MartingLenoirDiego/tfe/images/ldoB.PNG

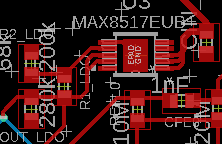
images/ldoB.PNG
