MartingLenoirDiego/tfe/documents/BoM tfe.xlsx

TFE : Epilepsy
 | Marting Lenoir Diego | 2022-03-30
# | Part Reference | Value | Package | Needed quantity per PCB | Quantity to order | Unit cost [€] | Total cost [€] | Description | Manufacturer Part Number | Manufacturer | Provider | Provider Part Number | Availability | Min quantity to order | Received
 | CVDD0 | 10µF | C0603 | 1 | 5 | 0.3900 | 1.9500 | CAPACITOR, 10µF, 0603, SMD | C0603C106M8PACTU | KEMET | Mouser | 80-C0603C106M8PACTU
 | CVVD1 | 10nF | C0603 | 1 | 5 | 0.1950 | 0.9750 | CAPACITOR, 10nF, 0603, SMD | 06033C103KAT2A | AVX | Mouser | 581-06033C103KAT2A
1 | CIN_LDO, COUT_LDO, C9VREF | 1µF | C0603 | 6 | 20 | 0.1690 | 3.3800 | CAPACITOR, 1µF, 0603, SMD | C1608X5R1H105K080AB | TDX | Mouser | 810-C1608X5R1H105K |  | 10
2 |  | 220nF | C0603 | 1 | 5 | 0.3050 | 1.5250 | CAPACITOR, 220nF, 0603, SMD | C0603C224K3RACTU | KEMET | Mouser | 80-C0603C224K3R
3 | CFILT1, CFILT2, CFILT3 | 150nF | C0603 | 3 | 10 | 0.0580 | 0.5800 | CAPACITOR, 150nF, 0603, SMD | C0603C154K5RACTU | KEMET | Mouser | 80-C0603C154K5R |  | 10
4 | CFILT2 | 100nF | C0603 | 1 | 5 | 0.3500 | 1.7500 | CAPACITOR, 100nF, 0603, SMD | 06033C104KAT2A | AVX | Mouser | 581-06033C104KAT2A |  | 10
5 | CFE0/1/2/3 | 1nF | C0603 | 4 | 10 | 0.0440 | 0.4400 | CAPACITOR, 1nF, 0603, SMD | 06031C102JAT2A | AVX | Mouser | 581-06031C102J |  | 10
6 | C_AAF_0/1/2/3 | 0,1nF | C0603 | 4 | 10 | 0.1050 | 1.0500 | CAPACITOR, 0,1nF, 0603, SMD | C0603C101K5RACTU | KEMET | Mouser | 80-C0603C101K5R |  | 10
7 | RFILT0, RFILT1, RFILT2 | 100MΩ | R0603 | 7 | 20 | 0.2520 | 5.0400 | RESISTOR, 100Mohm, 0603, SMD | CRCW0603100MJPEAHR | VISHAY | Mouser | 71-CRCW0603100MJPEA |  | 10
8 | RFER0/1/2/3, R9VREF | 20MΩ | R0603 | 5 | 10 | 0.3470 | 3.4700 | RESISTOR, 20Mohm, 0603, SMD | CRCW060320M0JPEAHR | VISHAY | Mouser | 71-CRCW0603J-20M-E3 |  | 10
9 | R0,6V, R0,9V, RFEL0/1/2/3 | 10MΩ | R0603 | 6 | 15 | 0.0220 | 0.3300 | RESISTOR, 10Mohm, 0603, SMD | CRCW060310M0FKEAC | VISHAY | Mouser | 71-CRCW060310M0FKEAC |  | 10
10 | R40, R41, R42, R43 | 7,5MΩ | R0603 | 4 | 10 | 0.0270 | 0.2700 | RESISTOR, 7,5Mohm, 0603, SMD | CRCW06037M50JNEA | VISHAY | Mouser | 71-CRCW0603J-7.5M-E3 |  | 1
11 | R30, R31, R32, R33 | 3MΩ | R0603 | 4 | 10 | 0.0260 | 0.2600 | RESISTOR, 3Mohm, 0603, SMD | CRCW06033M00FKEA | VISHAY | Mouser | 71-CRCW0603-3M-E3 |  | 10
12 | RLM334 | 68kΩ | R0603 | 2 | 10 | 0.0300 | 0.3000 | RESISTOR, 68kohm, 0603, SMD | CRCW060368K0FKEA | VISHAY | Mouser | 71-CRCW0603-68K-E3 |  | 10
13 | R_AAF_0/1/2/3 | 40kΩ | R0603 | 4 | 10 | 0.0260 | 0.2600 | RESISTOR, 40,2kohm, 0603, SMD | CRCW060340K2FKEA | VISHAY | Mouser | 71-CRCW0603-40.2K-E3 |  | 10
 |  | 28kΩ | R0603 | 1 | 10 | 0.0260 | 0.2600 | RESISTOR, 28kohm, 0603, SMD | CRCW060328K0FKEA | VISHAY | Mouser | 71-CRCW0603-28K-E3 |  | 10
 |  | 20kΩ | R0603 | 1 | 10 | 0.0250 | 0.2500 | RESISTOR, 20kohm, 0603, SMD | CRCW060320K0FKEB | VISHAY | Mouser | 71-CRCW060320K0FKEB |  | 10
14 | R20, R21, R22, R23 | 15kΩ | R0603 | 4 | 10 | 0.0240 | 0.2400 | RESISTOR, 15kohm, 0603, SMD | CRCW060315K0JNEA | VISHAY | Mouser | 71-CRCW0603J-15K-E3 |  | 10
15 |  | 2,8kΩ | R0603 | 1 | 5 | 0.1440 | 0.7200 | RESISTOR, 2,8kohm, 0603, SMD | CRCW06032K80FKEAHP | VISHAY | Mouser | 71-CRCW06032K80FKEAH |  | 10
16 |  | 2kΩ | R0603 | 1 | 5 | 0.0850 | 0.4250 | RESISTOR, 2kohm, 0603, SMD | CRCW06032K00FKEAC | VISHAY | Mouser | 71-CRCW06032K00FKEAC |  | 10
17 | R10, R11 | 1kΩ | R0603 | 4 | 10 | 0.0220 | 0.2200 | RESISTOR, 1kohm, 0603, SMD | CRCW06031K00FKEAC | VISHAY | Mouser | 71-CRCW06031K00FKEAC |  | 10
18 | LMD334DT | Current Sources | SO-8 | 2 | 5 | 0.9200 | 4.6000 | Régulateur de courant | LM334DT | STMICROELECTRONICS | Mouser | 511-LM334D-TR |  | 1
 | TPS7A0518PDBZR |  | DBZ | 1 | 3 | 0.6920 | 2.0760 | TPS7A0518PDBZR | TPS7A0518PDBZR | Texas Instruments | Mouser | 595-TPS7A0518PDBZR |  | 1
19 | TLV9042IDR | Ampli Op | SOIC-8 | 4 | 10 | 0.7280 | 7.2800 | Operational Amplifiers | TLV9042IDR | Texas Instruments | Mouser | 595-TLV9042IDR |  | 1
 |  | TOTAL = |  | 72 | 223 |  | 37.6510
