MartingLenoirDiego/tfe/schémas + board/PCB.brd

## EAGLE design schémas + board/PCB.brd (2022-03-17)

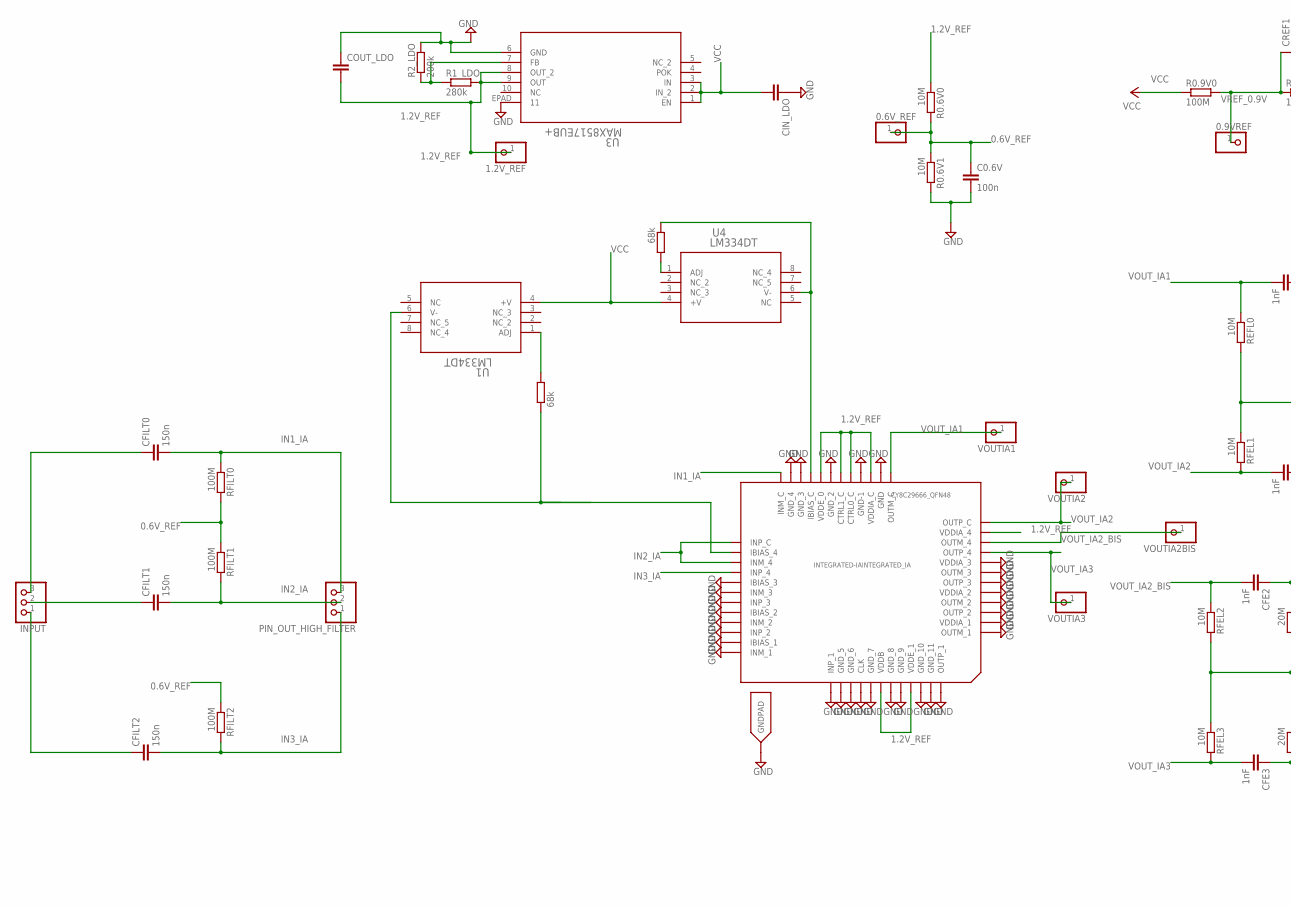
[picture p31: schematic PCB.sch, part in row 1, column 1]

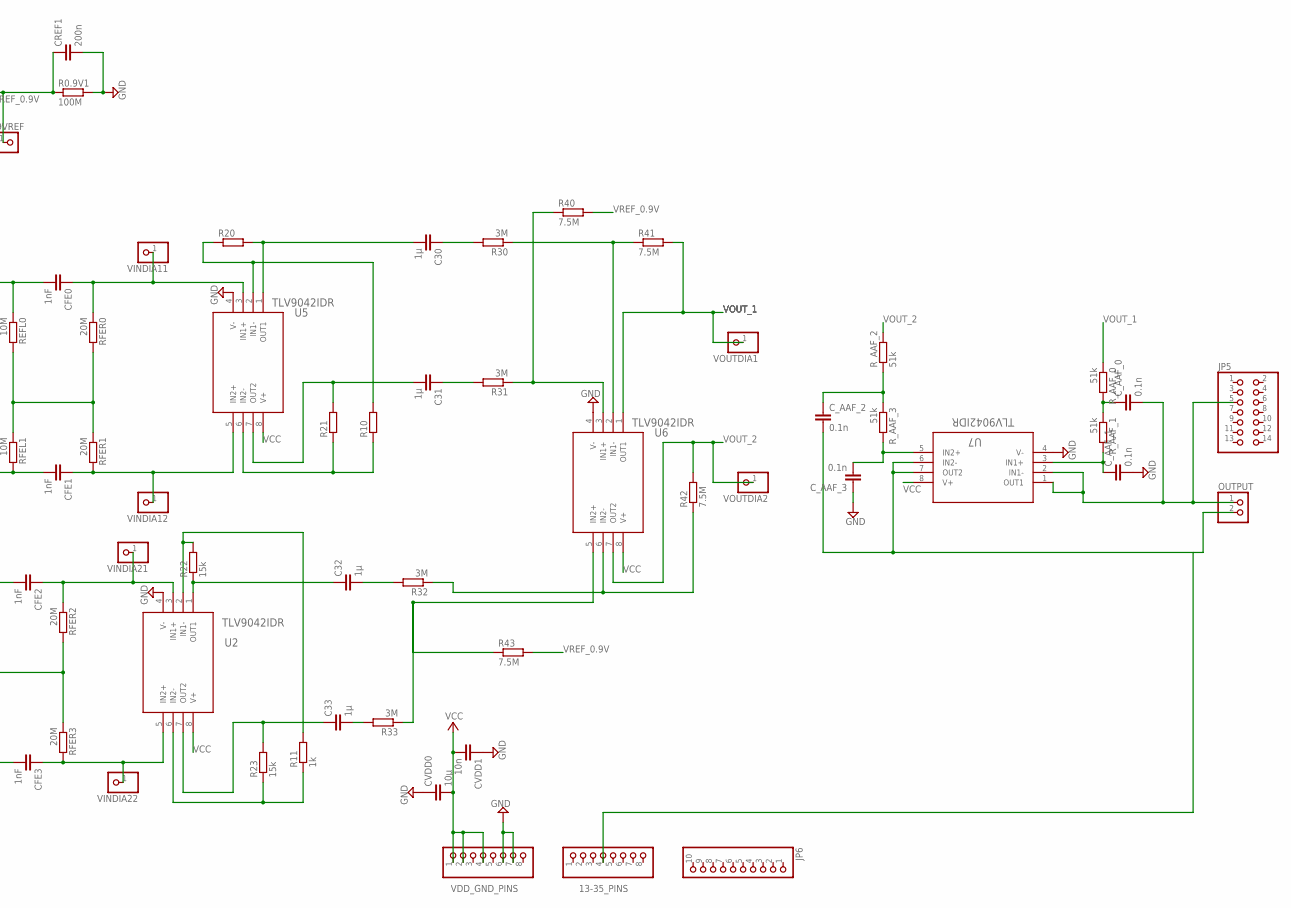
[picture p32: schematic PCB.sch, part in row 1, column 2]

Parts:
0.6V_REF, 0.9VREF, 1.2V_REF: PINHD-1X1; 1X01
13-35_PINS: PINHD-1X8; 1X08
C0.6V: 100n; C0603
C30, C31, C32, C33: 1µ; C0603
CFE0, CFE1, CFE2, CFE3: 1nF; C0603
CFILT0, CFILT1, CFILT2: 150n; C0603
CIN_LDO: 1µ; C0603
COUT_LDO: 4.7µ; C0603
CREF1: 200n; C0603
CVDD0: 10µ; C0603
CVDD1: 10n; C0603
C_AAF_0, C_AAF_1, C_AAF_2, C_AAF_3: 0.1n; C0603
INPUT: PINHD-1X3; 1X03
INTEGRATED-IA: CY8C29666_QFN48; QFN48
JP5: PINHD-2X7; 2X07
JP6: PINHD-1X10; 1X10
OUTPUT: PINHD-1X2; 1X02
PIN_OUT_HIGH_FILTER: PINHD-1X3; 1X03
R0.6V0, R0.6V1: 10M; R0603
R0.9V0, R0.9V1: 100M; R0603
R1_LDO: 280k; R0603
R2_LDO: 200k; R0603
R10, R20, R21: R-EU_R0603; R0603
R11: 1k; R0603
R22, R23: 15k; R0603
R30, R31, R32, R33: 3M; R0603
R40, R41, R42, R43: 7.5M; R0603
REFL0: 10M; R0603
RFEL1, RFEL2, RFEL3: 10M; R0603
RFER0, RFER1, RFER2, RFER3: 20M; R0603
RFILT0, RFILT1, RFILT2: 100M; R0603
RLM334_0, RLM334_1: 68k; R0603
R_AAF_0, R_AAF_1, R_AAF_2, R_AAF_3: 51k; R0603
U1, U4: LM334DT; SO-8_STM
U2, U5, U6, U7: TLV9042IDR; SOIC8_D_TEX
U3: MAX8517EUB+; 21-0109D_MXM
VDD_GND_PINS: PINHD-1X8; 1X08
VINDIA11, VINDIA12, VINDIA21, VINDIA22: PINHD-1X1; 1X01
VOUTDIA1, VOUTDIA2: PINHD-1X1; 1X01
VOUTIA1, VOUTIA2, VOUTIA2BIS, VOUTIA3: PINHD-1X1; 1X01

Connections:
0.6V_REF: 0.6V_REF.1, C0.6V.1, R0.6V0.2, R0.6V1.1, RFILT0.2, RFILT1.1, RFILT2.1
1.2V_REF: 1.2V_REF.1, COUT_LDO.2, INTEGRATED-IA.11 (VDDIA_4), INTEGRATED-IA.15 (VDDIA_C), INTEGRATED-IA.17 (CTRL0_C), INTEGRATED-IA.18 (CTRL1_C), INTEGRATED-IA.20 (VDDE_0), INTEGRATED-IA.42 (VDDB), INTEGRATED-IA.45 (VDDE_1), R0.6V0.1, R1_LDO.2, U3.8 (OUT_2), U3.9 (OUT)
GND: C0.6V.2, CIN_LDO.1, COUT_LDO.1, CREF1.2, CVDD0.1, CVDD1.1, C_AAF_1.2, C_AAF_3.1, INTEGRATED-IA.1 (OUTM_1), INTEGRATED-IA.2 (VDDIA_1), INTEGRATED-IA.3 (OUTP_2), INTEGRATED-IA.4 (OUTM_2), INTEGRATED-IA.5 (VDDIA_2), INTEGRATED-IA.6 (OUTP_3), INTEGRATED-IA.7 (OUTM_3), INTEGRATED-IA.8 (VDDIA_3), INTEGRATED-IA.14 (GND), INTEGRATED-IA.16 (GND-1), INTEGRATED-IA.19 (GND_2), INTEGRATED-IA.22 (GND_3), INTEGRATED-IA.23 (GND_4), INTEGRATED-IA.29 (IBIAS_3), INTEGRATED-IA.30 (INM_3), INTEGRATED-IA.31 (INP_3), INTEGRATED-IA.32 (IBIAS_2), INTEGRATED-IA.33 (INM_2), INTEGRATED-IA.34 (INP_2), INTEGRATED-IA.35 (IBIAS_1), INTEGRATED-IA.36 (INM_1), INTEGRATED-IA.37 (INP_1), INTEGRATED-IA.38 (GND_5), INTEGRATED-IA.39 (GND_6), INTEGRATED-IA.40 (CLK), INTEGRATED-IA.41 (GND_7), INTEGRATED-IA.43 (GND_8), INTEGRATED-IA.44 (GND_9), INTEGRATED-IA.46 (GND_10), INTEGRATED-IA.47 (GND_11), INTEGRATED-IA.48 (OUTP_1), INTEGRATED-IA.EXP (GNDPAD), R0.6V1.2, R0.9V1.2, R2_LDO.2, U2.4 (V-), U3.6 (GND), U3.EPAD (11), U5.4 (V-), U6.4 (V-), U7.4 (V-), VDD_GND_PINS.6, VDD_GND_PINS.7
IN1_IA: CFILT0.2, INTEGRATED-IA.24 (INM_C), PIN_OUT_HIGH_FILTER.3, RFILT0.1
IN2_IA: CFILT1.2, INTEGRATED-IA.25 (INP_C), INTEGRATED-IA.27 (INM_4), PIN_OUT_HIGH_FILTER.2, RFILT1.2
IN3_IA: CFILT2.2, INTEGRATED-IA.28 (INP_4), PIN_OUT_HIGH_FILTER.1, RFILT2.2
unnamed: C33.2, R33.2
unnamed: C32.1, R22.1, U2.1 (OUT1)
unnamed: C32.2, R32.2
unnamed: R32.1, R42.1, U6.6 (IN2-)
unnamed: CFILT2.1, INPUT.1
unnamed: R33.1, R43.1, U6.5 (IN2+)
unnamed: REFL0.2, RFEL1.1, RFER0.2, RFER1.1
unnamed: R31.1, R40.1, U6.3 (IN1+)
unnamed: C31.1, R31.2
unnamed: C30.1, R30.2
unnamed: C31.2, R21.2, U5.7 (OUT2)
unnamed: RLM334_1.2, U1.1 (ADJ)
unnamed: CFILT0.1, INPUT.3
unnamed: R1_LDO.1, R2_LDO.1, U3.7 (FB)
unnamed: RLM334_0.2, U4.1 (ADJ)
unnamed: C_AAF_2.1, R_AAF_2.1, R_AAF_3.1
unnamed: C30.2, R20.2, U5.1 (OUT1)
unnamed: C_AAF_0.1, R_AAF_0.2, R_AAF_1.1
unnamed: C_AAF_1.1, R_AAF_1.2, U7.3 (IN1+)
unnamed: C_AAF_3.2, R_AAF_3.2, U7.5 (IN2+)
unnamed: 13-35_PINS.4, C_AAF_2.2, OUTPUT.2, U7.6 (IN2-), U7.7 (OUT2)
unnamed: C_AAF_0.2, JP5.5, OUTPUT.1, U7.1 (OUT1), U7.2 (IN1-)
unnamed: R30.1, R41.1, U6.2 (IN1-)
unnamed: R10.1, R21.1, U5.6 (IN2-)
unnamed: C33.1, R23.2, U2.7 (OUT2)
unnamed: R11.1, R23.1, U2.6 (IN2-)
unnamed: R10.2, R20.1, U5.2 (IN1-)
unnamed: INTEGRATED-IA.26 (IBIAS_4), RLM334_1.1, U1.6 (V-)
unnamed: R11.2, R22.2, U2.2 (IN1-)
unnamed: CFE3.1, RFER3.2, U2.5 (IN2+), VINDIA22.1
unnamed: RFEL2.2, RFEL3.1, RFER2.2, RFER3.1
unnamed: CFE2.1, RFER2.1, U2.3 (IN1+), VINDIA21.1
unnamed: INTEGRATED-IA.21 (IBIAS_C), RLM334_0.1, U4.6 (V-)
unnamed: CFE0.1, RFER0.1, U5.3 (IN1+), VINDIA11.1
unnamed: CFE1.1, RFER1.2, U5.5 (IN2+), VINDIA12.1
unnamed: CFILT1.1, INPUT.2
VCC: CIN_LDO.2, CVDD0.2, CVDD1.2, R0.9V0.1, U1.4 (+V), U2.8 (V+), U3.1 (EN), U3.2 (IN_2), U3.3 (IN), U4.4 (+V), U5.8 (V+), U6.8 (V+), U7.8 (V+), VDD_GND_PINS.1, VDD_GND_PINS.2, VDD_GND_PINS.4
VOUT_1: R41.2, R_AAF_0.1, U6.1 (OUT1), VOUTDIA1.1
VOUT_2: R42.2, R_AAF_2.2, U6.7 (OUT2), VOUTDIA2.1
VOUT_IA1: CFE0.2, INTEGRATED-IA.13 (OUTM_C), REFL0.1, VOUTIA1.1
VOUT_IA2: CFE1.2, INTEGRATED-IA.12 (OUTP_C), RFEL1.2, VOUTIA2.1
VOUT_IA2_BIS: CFE2.2, INTEGRATED-IA.10 (OUTM_4), RFEL2.1, VOUTIA2BIS.1
VOUT_IA3: CFE3.2, INTEGRATED-IA.9 (OUTP_4), RFEL3.2, VOUTIA3.1
VREF_0.9V: 0.9VREF.1, CREF1.1, R0.9V0.2, R0.9V1.1, R40.2, R43.2

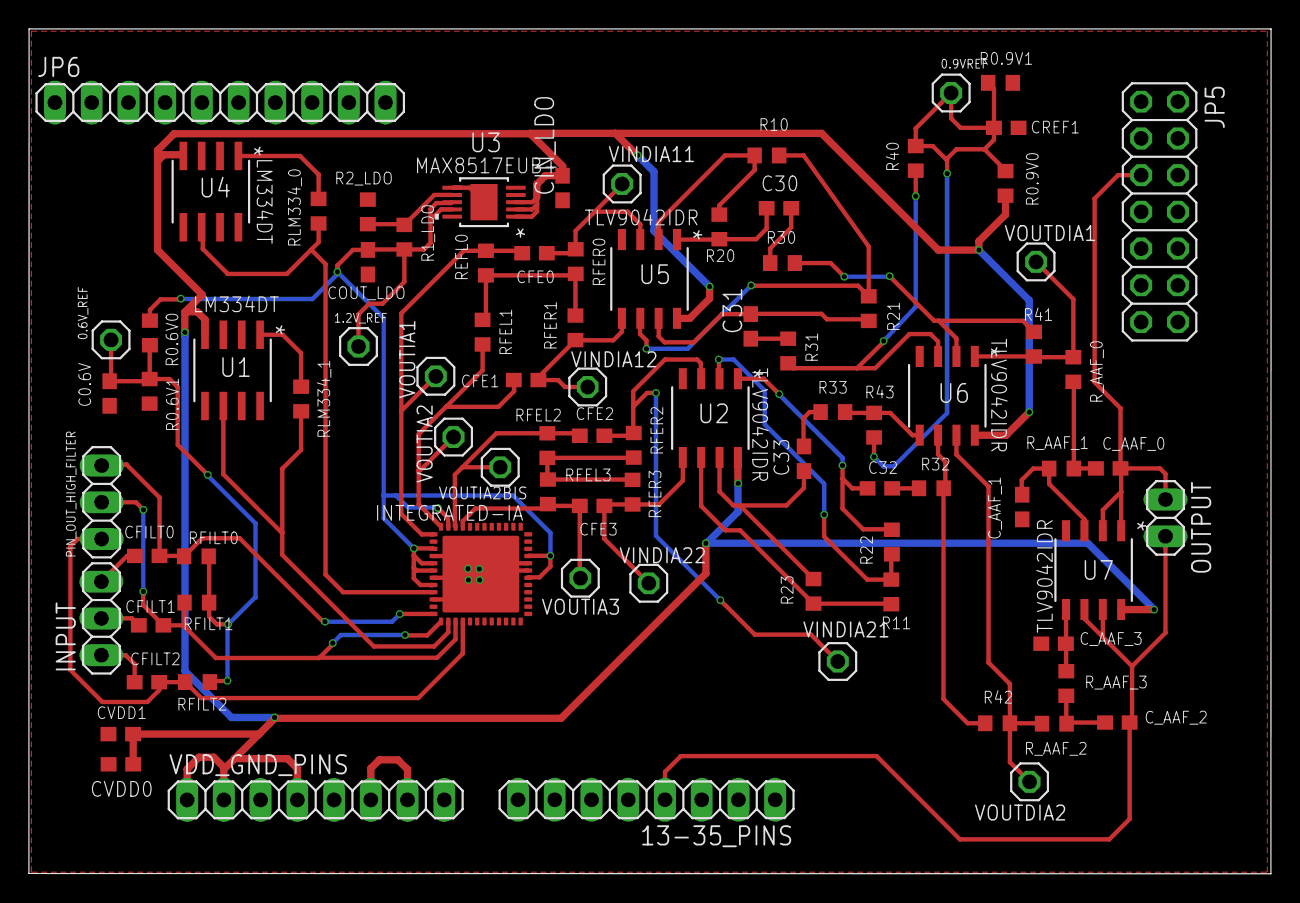
[picture p33: board PCB.brd from above]

Board: 2 copper layers, 85.9 x 58.4 mm, 86 parts (0 on the bottom side), 50 nets.
