MartingLenoirDiego/tfe/code/Apollo/common/base_types.h

/*******************************************************************************
* Copyright (C) 2013-2016, Fujitsu Electronics Europe GmbH or a                *
* subsidiary of Fujitsu Electronics Europe GmbH.  All rights reserved.         *
*                                                                              *
* This software, including source code, documentation and related              *
* materials ("Software"), is owned by Fujitsu Electronics Europe GmbH or       *
* one of its subsidiaries ("Fujitsu").
*                                                                              *
* If no EULA applies, Fujitsu hereby grants you a personal, non-exclusive,     *
* non-transferable license to copy, modify, and compile the                    *
* Software source code solely for use in connection with Fujitsu's             *
* integrated circuit products.  Any reproduction, modification, translation,   *
* compilation, or representation of this Software except as specified          *
* above is prohibited without the express written permission of Fujitsu.       *
*                                                                              *
* Disclaimer: THIS SOFTWARE IS PROVIDED AS-IS, WITH NO                         *
* WARRANTY OF ANY KIND, EXPRESS OR IMPLIED, INCLUDING,                         *
* BUT NOT LIMITED TO, NONINFRINGEMENT, IMPLIED                                 *
* WARRANTIES OF MERCHANTABILITY AND FITNESS FOR A                              *
* PARTICULAR PURPOSE. Fujitsu reserves the right to make                       *
* changes to the Software without notice. Fujitsu does not assume any          *
* liability arising out of the application or use of the Software or any       *
* product or circuit described in the Software. Fujitsu does not               *
* authorize its products for use in any products where a malfunction or        *
* failure of the Fujitsu product may reasonably be expected to result in       *
* significant property damage, injury or death ("High Risk Product"). By       *
* including Fujitsu's product in a High Risk Product, the manufacturer         *
* of such system or application assumes all risk of such use and in doing      *
* so agrees to indemnify Fujitsu against all liability.                        *
*******************************************************************************/

/*****************************************************************************/
/** \file base_types.h
 **
 ** Additional base type definitions to stddef.h and stdint.h
 **
 ** History:
 **   - 2016-09-12  1.0  Manuel Schreiner  First version.
 **
 *****************************************************************************/

#ifndef __BASE_TYPES_H__
#define __BASE_TYPES_H__

/*****************************************************************************/
/* Include files                                                             */
/*****************************************************************************/
#include <stddef.h>
#include "stdint.h"
  
/*****************************************************************************/
/* Global pre-processor symbols/macros ('#define')                           */
/*****************************************************************************/
#ifndef TRUE
  /** Value is true (boolean_t type) */
  #define TRUE        ((boolean_t) 1)
#endif

#ifndef FALSE
  /** Value is false (boolean_t type) */
  #define FALSE       ((boolean_t) 0)
#endif  

/** Returns the minimum value out of two values */
#define MIN( X, Y )  ((X) < (Y) ? (X) : (Y))

/** Returns the maximum value out of two values */
#define MAX( X, Y )  ((X) > (Y) ? (X) : (Y))

/** Returns the dimension of an array */
#define DIM( X )  (sizeof(X) / sizeof(X[0]))

/******************************************************************************
 * Global type definitions
 ******************************************************************************/

/** logical datatype (only values are TRUE and FALSE) */
typedef uint8_t      boolean_t;
  
/** single precision floating point number (4 byte) */
typedef float        float32_t;

/** double precision floating point number (8 byte) */
typedef double       float64_t;

/** ASCCI character for string generation (8 bit) */
typedef char         char_t;

/** function pointer type to void/void function */
typedef void         (*func_ptr_t)(void);

/** function pointer type to void/uint8_t function */
typedef void         (*func_ptr_arg1_t)(uint8_t);

/** generic error codes */
typedef enum en_result
{
    Ok                          = 0,  ///< No error
    Error                       = 1,  ///< Non-specific error code
    ErrorAddressAlignment       = 2,  ///< Address alignment does not match
    ErrorAccessRights           = 3,  ///< Wrong mode (e.g. user/system) mode is set
    ErrorInvalidParameter       = 4,  ///< Provided parameter is not valid
    ErrorOperationInProgress    = 5,  ///< A conflicting or requested operation is still in progress
    ErrorInvalidMode            = 6,  ///< Operation not allowed in current mode
    ErrorUninitialized          = 7,  ///< Module (or part of it) was not initialized properly
    ErrorBufferFull             = 8,  ///< Circular buffer can not be written because the buffer is full
    ErrorTimeout                = 9,  ///< Time Out error occurred (e.g. I2C arbitration lost, Flash time-out, etc.)
    ErrorNotReady               = 10, ///< A requested final state is not reached
    OperationInProgress         = 11  ///< Indicator for operation in progress (e.g. ADC conversion not finished, DMA channel used, etc.)
} en_result_t;     

/*****************************************************************************/
/* Global variable declarations ('extern', definition in C source)           */
/*****************************************************************************/

/*****************************************************************************/
/* Global function prototypes ('extern', definition in C source)             */
/*****************************************************************************/

#endif /* __BASE_TYPES_H__ */

/******************************************************************************/
/* EOF (not truncated)                                                        */
/******************************************************************************/
