MartingLenoirDiego/tfe/code/Apollo/common/system_apollo3.h

//*****************************************************************************
//
//! @file system_Apollo3.h
//!
//! @brief Ambiq Micro Apollo3 MCU specific functions.
//
//*****************************************************************************

//*****************************************************************************
//
// ${copyright}
//
//*****************************************************************************

#ifndef SYSTEM_APOLLO3_H
#define SYSTEM_APOLLO3_H

#ifdef __cplusplus
extern "C" {
#endif

#include <stdint.h>

extern uint32_t SystemCoreClock;     // System Clock Frequency (Core Clock)

//*****************************************************************************
//
// External function definitions
//
//*****************************************************************************
extern void SystemInit (void);
extern void SystemCoreClockUpdate (void);

#ifdef __cplusplus
}
#endif

#endif  // SYSTEM_APOLLO3_H
