MartingLenoirDiego/tfe/(commit log)

2022-03-30 mise à jour bom
    [BOM.xlsx, Copie de BOM.xlsx]
2022-05-09 code transfert uart
2022-05-23 code uart adc
